davek184/nt-series/nt-660/plate/README.md

Plate files are experimental! A sample plate was ordered Sept 8th.  

Norbauer Heavy-6 plate should be bend for strength.

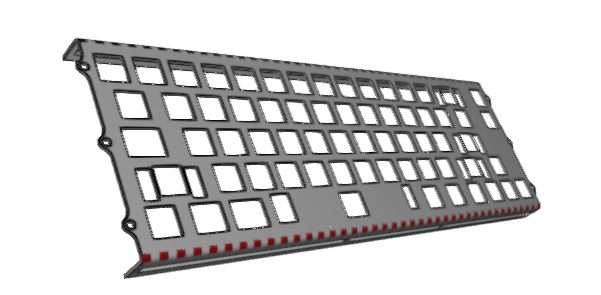
[picture p1: nt-660/plate/assets/plateFlat.png]
Plate Flat


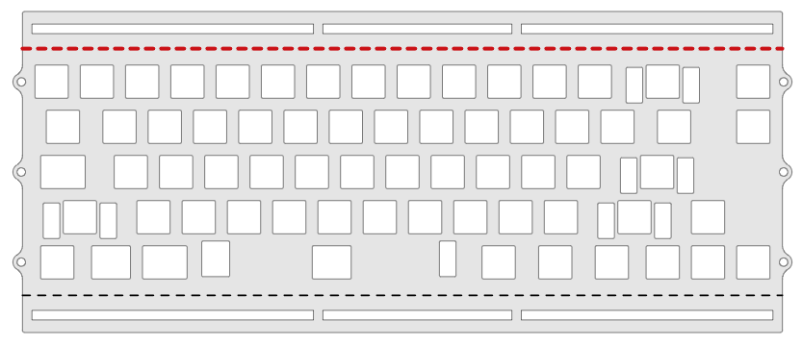
[picture p2: nt-660/plate/assets/plateRender.png]
Plate Flat
