davek184/nt-series/nt-660/daughterboard/README.md

# Daughterboard

USB-C daughterboard for Norbauer's Heavy-6 case. 

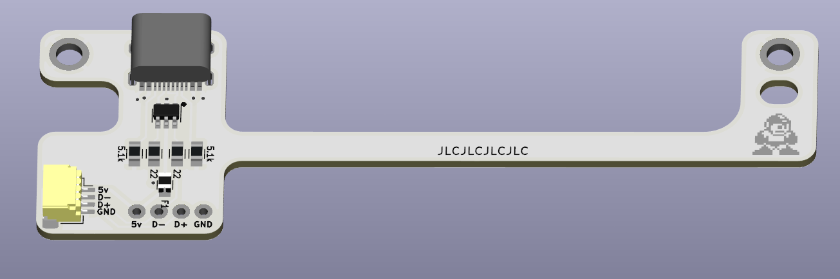
[picture p3: nt-660/daughterboard/assets/daughterboard.png]
render


# Manufacturing:
 - Files in Manufacturing folder are setup for JLCPCB
 - Note: Choose Specify a location under Remove order number
