davek184/nt-series/nt-980/plate/production/README.md

This Gerber file was used to make FR4 plates from JLCPCB.  The JLCPCB gerber viewer is a bit wonky.  This will show up yellow on the viewer but came out okay for me.  They may come back after your order has been placed asking for an additional $15 due to all the holes.

Guide at making FR4 gerber files: https://scottw.com/keyboards/dxf-to-fr4/

Some photos here: https://imgur.com/a/Q7dKFkK

Use at your own risk.
