davek184/nt-series/nt-210/pcb-outline.dxf

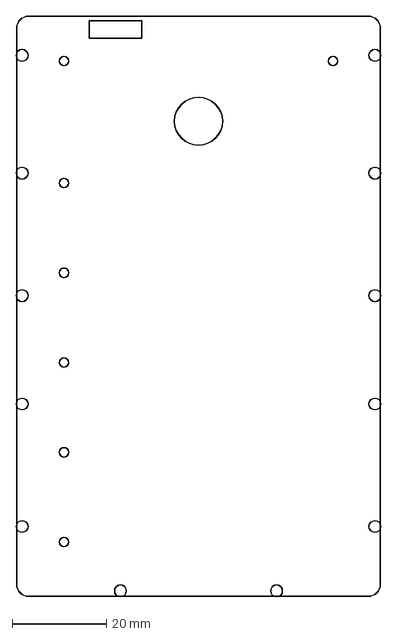
[picture p4: CAD file, 2023-02-12]
nt-210/pcb-outline.dxf
77.3 x 123.2 mm
