davek184/nt-series/nt-980/heavy-9-adapter/Heavy-9 Adapter - No Stem.v3.stl

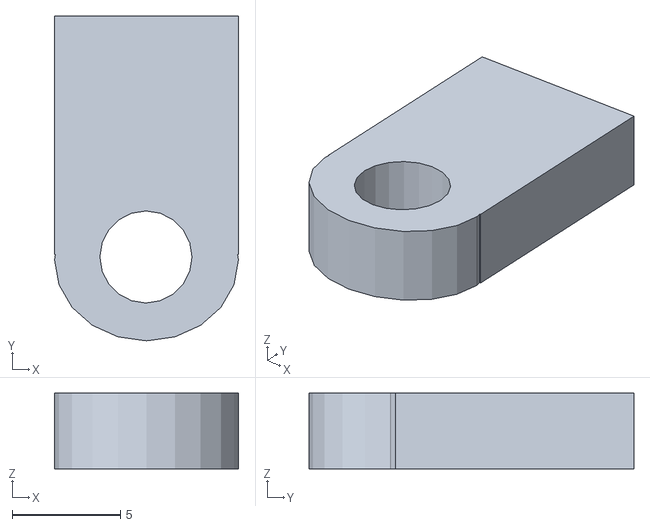
[picture p5: CAD file, 2021-08-22]
nt-980/heavy-9-adapter/Heavy-9 Adapter - No Stem.v3.stl
8.50 x 15.0 x 3.50
