davek184/nt-series/nt-980/heavy-9-adapter/Heavy-9 Adapter - Center - No Stem.v3.stl

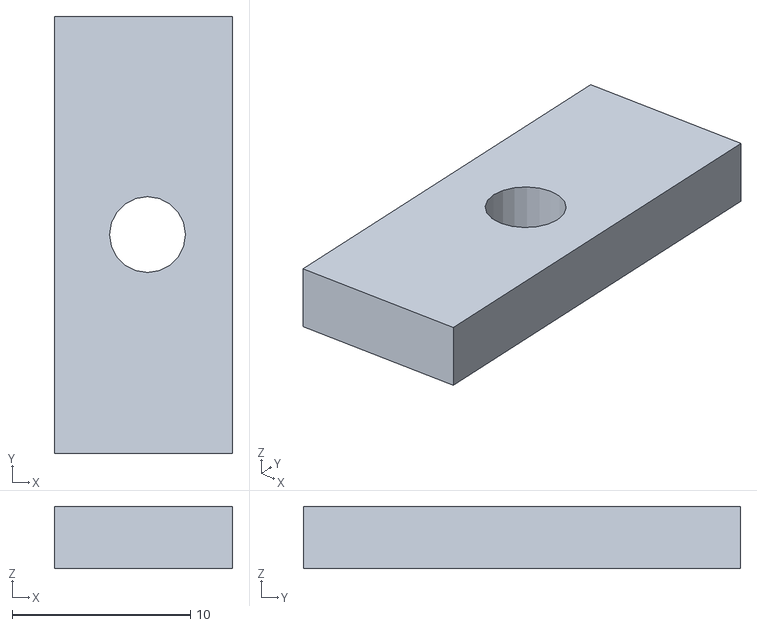
[picture p6: CAD file, 2021-08-22]
nt-980/heavy-9-adapter/Heavy-9 Adapter - Center - No Stem.v3.stl
10.0 x 24.5 x 3.50
