davek184/nt-series/nt-980/heavy-9-adapter/Heavy-9 USB plate v4.stl

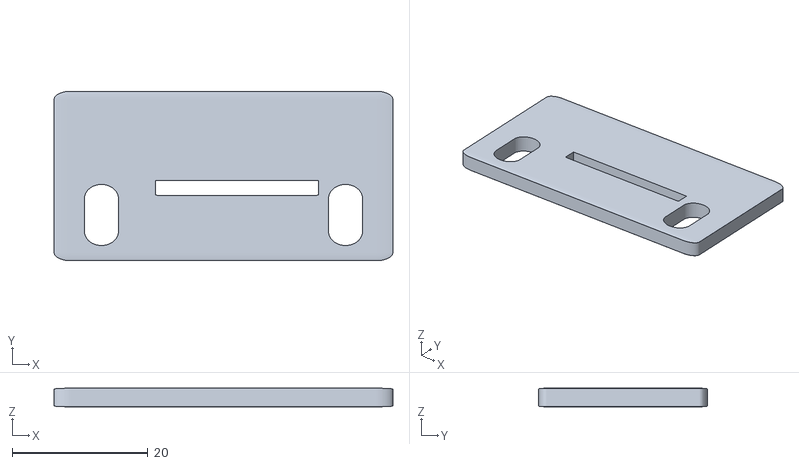
[picture p7: CAD file, 2021-08-22]
nt-980/heavy-9-adapter/Heavy-9 USB plate v4.stl
50.0 x 25.0 x 2.75
