davek184/nt-series/nt-210/nt210.kicad_pcb

## KiCad design nt-210/nt210.kicad_pcb (2023-02-12)

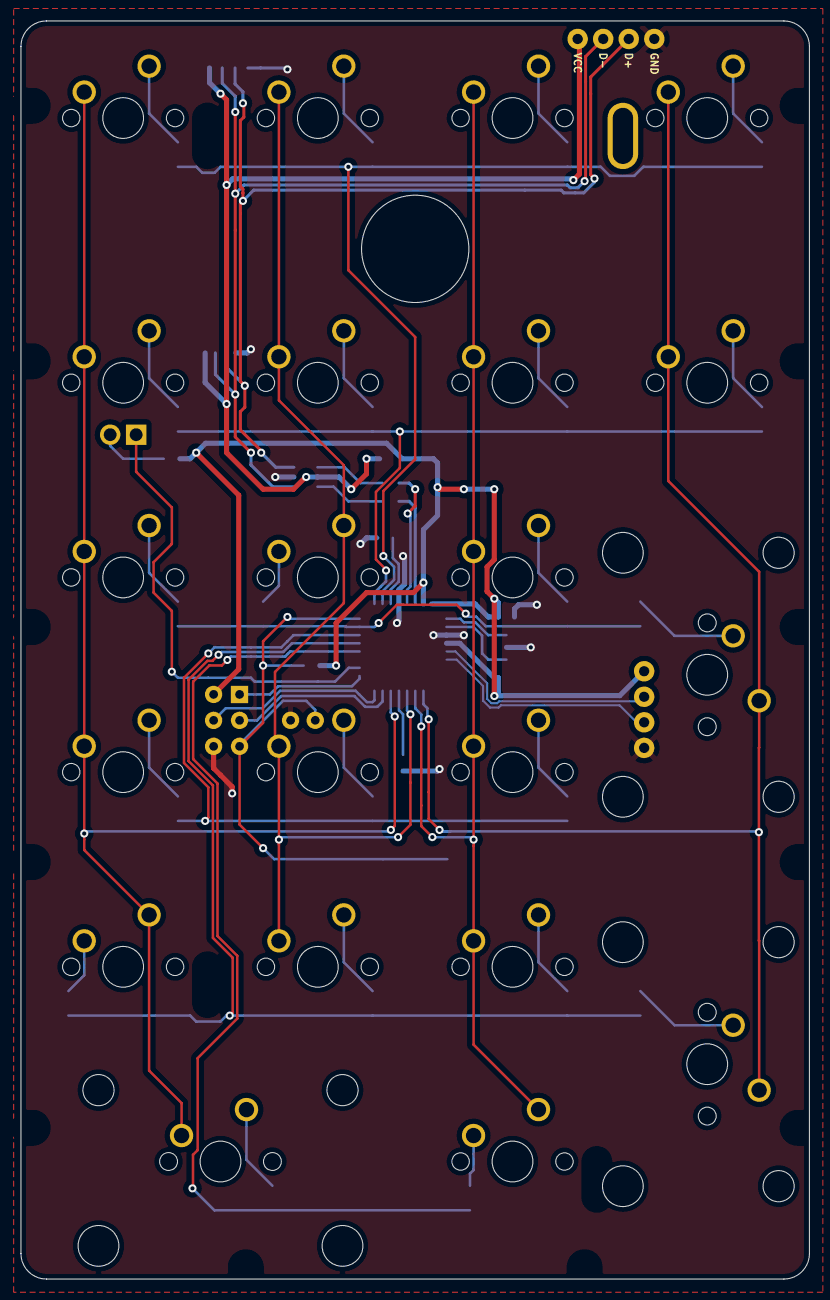
[picture p8: board nt210.kicad_pcb from above]

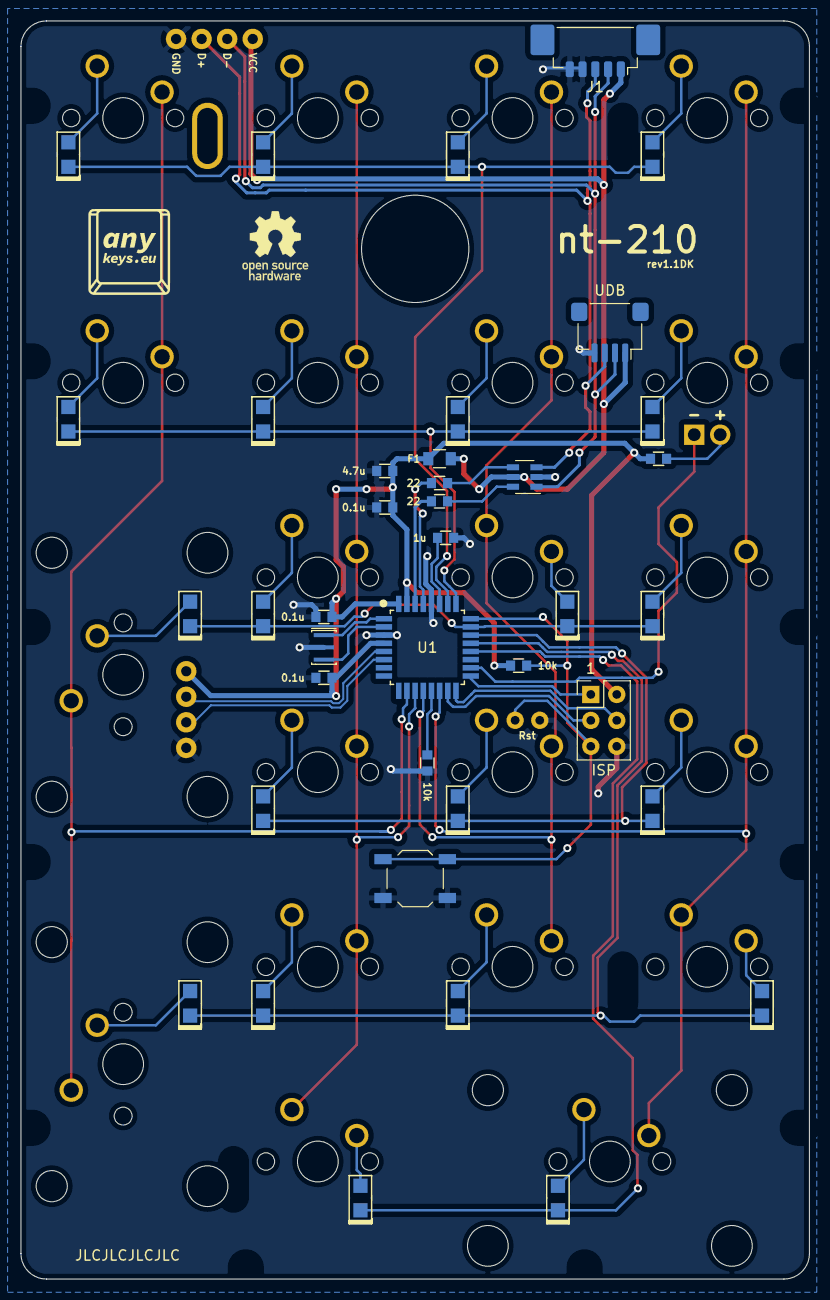
[picture p9: board nt210.kicad_pcb from below]

Board: 2 copper layers, 77.2 x 123.1 mm, 62 parts (39 on the bottom side), 50 nets.

Parts:
C1, C2, C3: 0.1u; C_0603
C4: 4.7u; C_0603
C5: 1u; C_0603
D1, D2, D3, D4, D5, D6, D7, D8, D9, D10, D11, D12, D13, D14, D15, D17, D18, D19, D20, D21, D23: D; D_0805
F1: Fuse; F_0805
J1: 53398-0571; Molex-PicoBlade-533980571
J2: ISP; isp_standard
J3: UDB; JST_SH_SM04B-SRSS-TB_1x04-1MP_P1.00mm_Horizontal
J4: Solder header; solder_header
K1, K2, K3, K4, K5, K6, K7, K8, K9, K10, K11, K13, K14, K15, K17, K18, K19, K23: KEYSW; CHERRY_PLATE_100H
K20, K20#2, K21: KEYSW; Mx-2.00U
L1: LED; CHERRY_MX_LED_neo
R1, R2: 22; R_0603
R3, R4: 10k; R_0603
R5: 1k; R_0603
SW1: Reset; SW_SPST_TL3342
U1: ATMEGA32U2
U2: USBLC6-2SC6
X1: 16mhz; Resonator_SMD_muRata_CSTNExxV-3Pin-p1.2

Connections:
D+: J1.3, J3.3, J4.3, U1.5 (PC2), U2.3 (I/O2)
D-: J1.2, J3.2, J4.2, U1.6 (PD0), U2.1 (I/O1)
GND: C1.2, C2.2, C3.2, C4.2, C5.2, J1.4, J1.5, J2.6, J3.4, J4.4, R3.1, SW1.1, U1.3 (GND), U1.28 (UGND), U2.2 (GND), X1.3
MISO: J2.1, U1.17 (PB3)
MOSI: J2.4, U1.16 (PB2)
unnamed: C5.1, U1.27 (UCap)
unnamed: D1.2 (A), K1.1
unnamed: D2.2 (A), K2.1
unnamed: D3.2 (A), K3.1
unnamed: D4.2 (A), K4.1
unnamed: D5.2 (A), K5.1
unnamed: D6.2 (A), K6.1
unnamed: D7.2 (A), K7.1
unnamed: D8.2 (A), K8.1
unnamed: D9.2 (A), K9.1
unnamed: D10.2 (A), K10.2
unnamed: D11.2 (A), K11.1
unnamed: D12.2 (A), K20.2
unnamed: D13.2 (A), K13.1
unnamed: D14.2 (A), K14.1
unnamed: D15.2 (A), K15.1
unnamed: D17.2 (A), K17.2
unnamed: D18.2 (A), K18.1
unnamed: D19.2 (A), K19.1
unnamed: D20.2 (A), K20#2.2
unnamed: D21.2 (A), K21.1
unnamed: D23.2 (A), K23.2
unnamed: L1.1 (K), U1.18 (PB4)
unnamed: L1.2 (A), R5.2
unnamed: R1.1, U1.30 (D-)
unnamed: R1.2, U2.6 (I/O1)
unnamed: R2.1, U1.29 (D+)
unnamed: R2.2, U2.4 (I/O2)
unnamed: R3.2, U1.13 (PD7/~HWB)
unnamed: U1.1 (XTAL1), X1.1
unnamed: U1.2 (XTAL2), X1.2
RST: J2.5, R4.1, SW1.2, U1.24 (~RESET)
SCK: J2.3, U1.15 (PB1)
VCC: C1.1, C2.1, C3.1, C4.1, F1.1, J2.2, R4.2, R5.1, U1.4 (VCC), U1.31 (UVCC), U1.32 (AVCC)
VUSB: F1.2, J1.1, J3.1, J4.1, U2.5 (VBUS)
col0: K1.2, K5.2, K9.2, K13.2, K17.1, K21.2, U1.14 (PB0)
col1: K2.2, K6.2, K10.1, K14.2, K18.2, U1.12 (PD6)
col2: K3.2, K7.2, K11.2, K15.2, K19.2, K23.1, U1.11 (PD5)
col3: K4.2, K8.2, K20.1, K20#2.1, U1.10 (PD4)
row0: D1.1 (K), D2.1 (K), D3.1 (K), D4.1 (K), U1.26 (PC4)
row1: D5.1 (K), D6.1 (K), D7.1 (K), D8.1 (K), U1.25 (PC5)
row2: D9.1 (K), D10.1 (K), D11.1 (K), D12.1 (K), U1.23 (PC6)
row3: D13.1 (K), D14.1 (K), D15.1 (K), U1.22 (PC7)
row4: D17.1 (K), D18.1 (K), D19.1 (K), D20.1 (K), U1.21 (PB7)
row5: D21.1 (K), D23.1 (K), U1.20 (PB6)
