davek184/nt-series/nt-660/daughterboard/nt660c.daughterboard.kicad_pcb

## KiCad design nt-660/daughterboard/nt660c.daughterboard.kicad_pcb (2022-08-31)

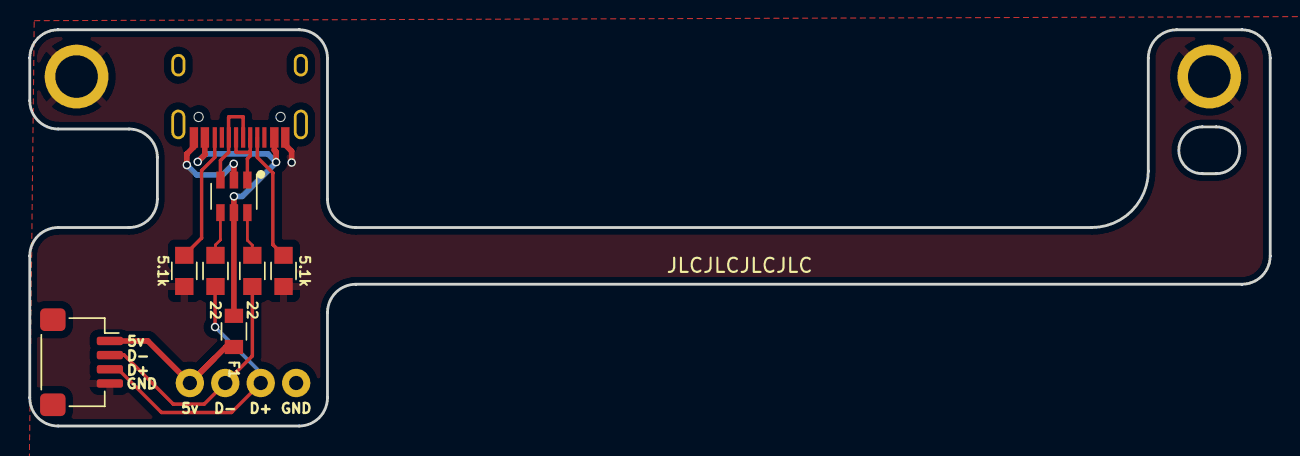
[picture p13: board nt660c.daughterboard.kicad_pcb from above]

Board: 2 copper layers, 87.5 x 27.9 mm, 11 parts (0 on the bottom side), 11 nets.

Parts:
F1: Polyfuse_Small; F_0805
J1: HRO-TYPE-C-31-M-12
J2: ai03_ud; JST_SH_SM04B-SRSS-TB_1x04-1MP_P1.00mm_Horizontal
J4: Solder header; solder_header
R1, R2: 22; R_0805
R5, R6: 5.1k; R_0805
S1, S2: SCREW; screw
U2: USBLC6-2SC6

Connections:
D+: R1.1, U2.4 (I/O2)
D-: R2.1, U2.6 (I/O1)
GND: J1.1 (GND), J1.12 (GND), J2.4, R5.2, R6.2, S1.1, S2.1, U2.2 (GND)
unnamed: J1.4 (CC1), R5.1
unnamed: J1.5 (DN2), J1.7 (DN1), U2.1 (I/O1)
unnamed: J1.6 (DP1), J1.8 (DP2), U2.3 (I/O2)
unnamed: J1.10 (CC2), R6.1
unnamed: J2.3, J4.3, R1.2
unnamed: J2.2, J4.2, R2.2
VBUS: F1.2, J1.2 (VBUS), J1.11 (VBUS), U2.5 (VBUS)
VCC: F1.1, J2.1, J4.1
