davek184/nt-series/(commit log)

2022-01-04 USB-Mini Daughterboard
    [980Daughterboard-USB-Mini.kicad_pcb]
2022-01-16 Add files via upload
    From Tinster4x4 adapter for Keebio USB-C breakout board to stock case
    [USB_C_Holder_2mm_with_PCB_cutout_v3.stl]
2022-04-15 Add files via upload
    Interactive BOM for version 1.2
2022-04-22 Revision 1.2
    [980Daughterboard-USB-C.BOM.csv, 980Daughterboard-USB-C.kicad_pcb, 980Daughterboard-USB-C.kicad_sch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]
2022-08-31 Add Daughterboard
    [bom.csv, nt660c.daughterboard.kicad_pcb, nt660c.daughterboard.kicad_sch, positions.csv]
2022-08-31 add JLCPCB manufacturing files
    [nt600.dk.bom.JLC.csv, nt660.dk.bom.JLC.csv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]
2022-08-31 fixed gerber file
2022-11-09 Production files version 1.3
    Added JST/QWIIC connectors to production assembly bom/pos files
    [nt980.dk.bom.JLC.csv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]
2022-11-09 Design fixed designators for QWIIC connectors
2023-02-12 nt-210dk
    Deviated from Evy's removed extra keys. Added reset pins and breakout mcu pins
    [nt210-B_Cu.gbr, nt210-B_Fab.gbr, nt210-B_Mask.gbr, nt210-B_Paste.gbr, nt210-B_Silkscreen.gbr, nt210-Edge_Cuts.gbr, nt210-F_Cu.gbr, nt210-F_Mask.gbr]
